damianjarczok/Solar-tracker/Schemat.png

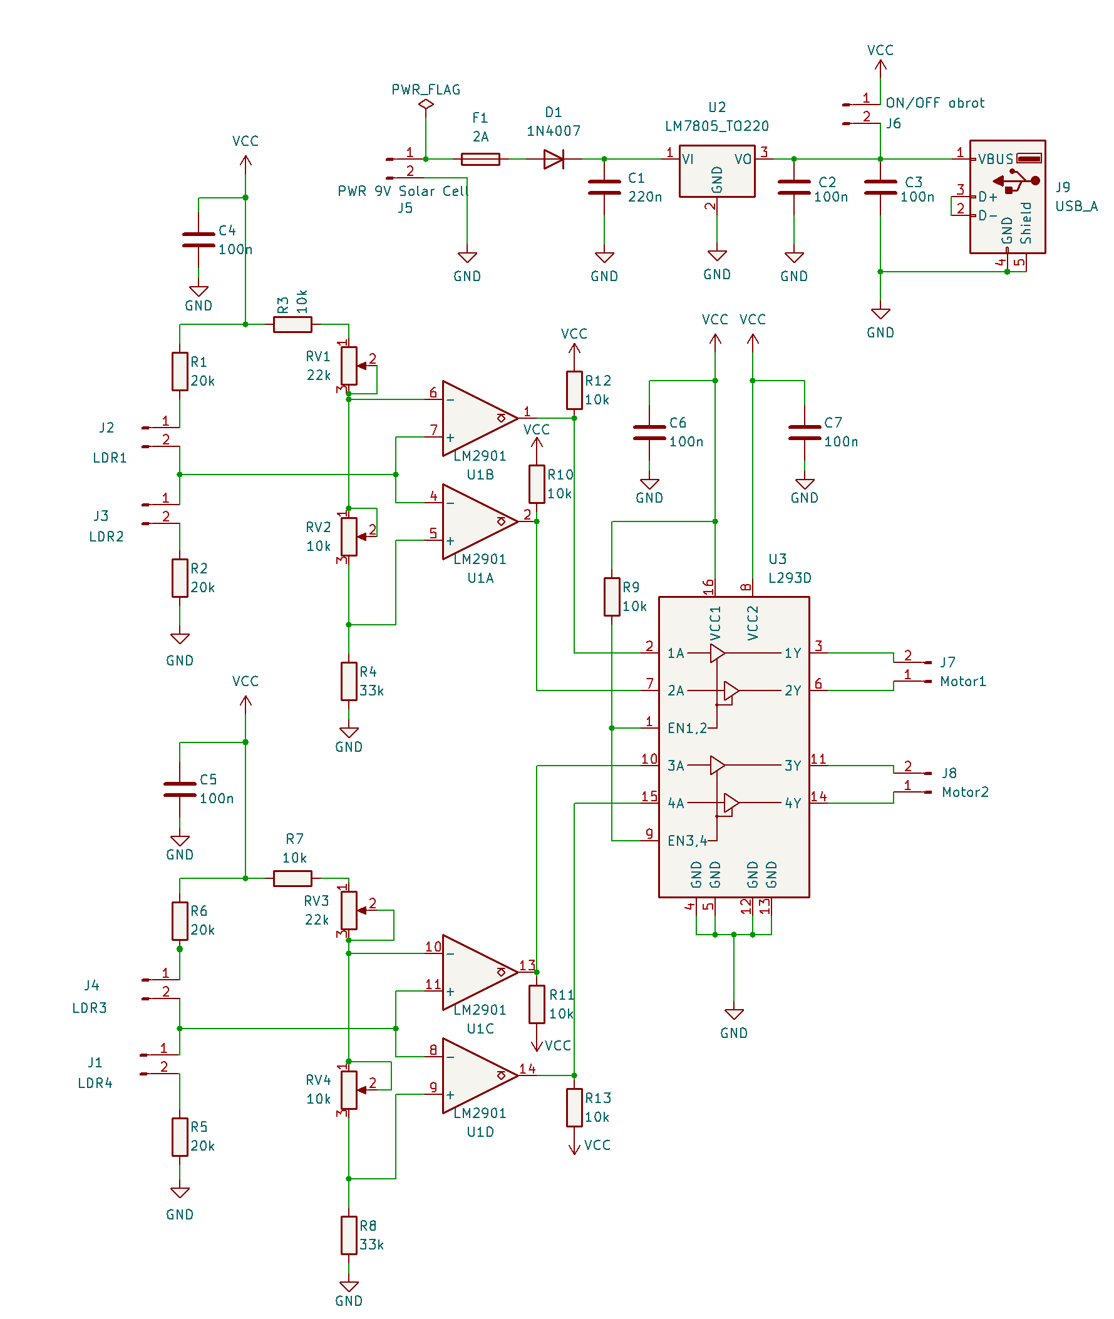
Schemat.png
