damianjarczok/Solar-tracker/SolarTracker.kicad_pcb

## KiCad design SolarTracker.kicad_pcb (2025-08-06)

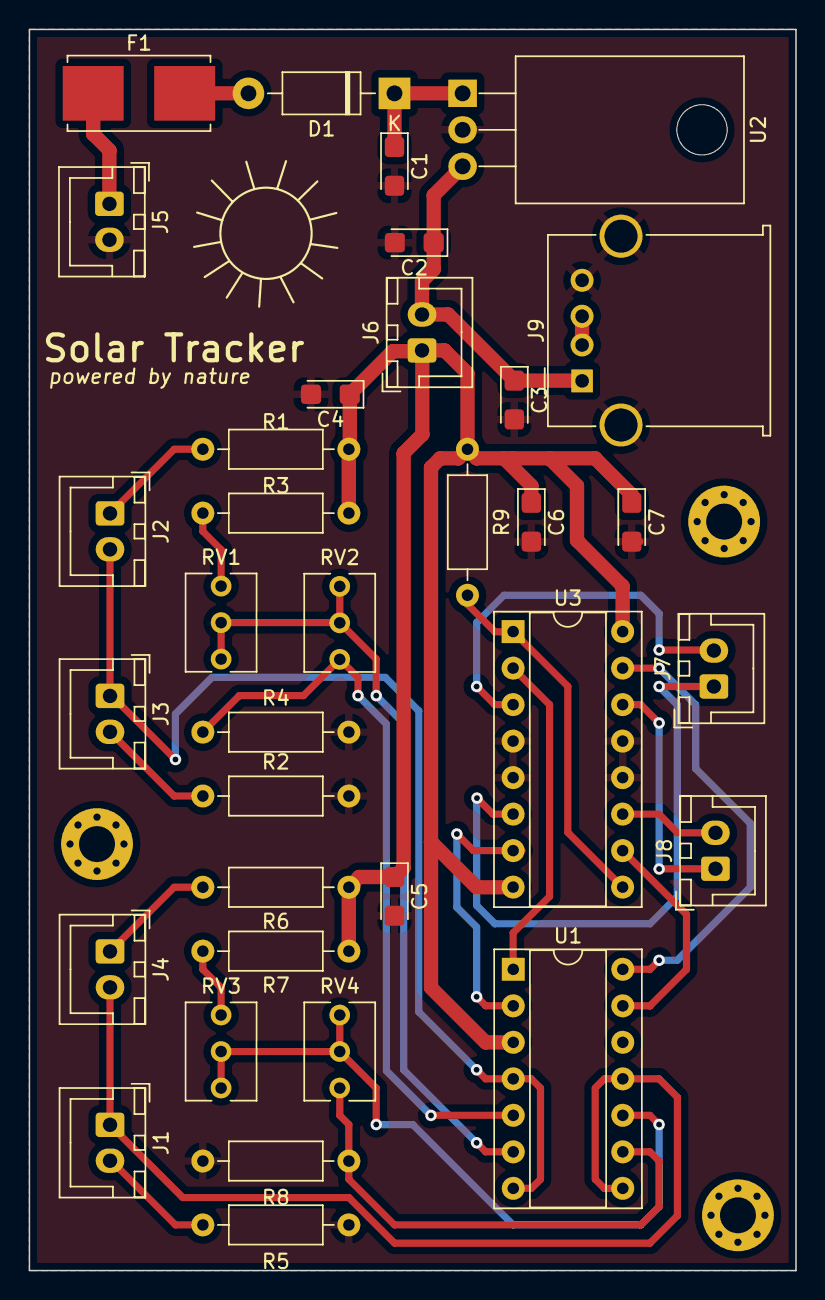
[picture p6: board SolarTracker.kicad_pcb from above]

Board: 2 copper layers, 53.3 x 86.4 mm, 34 parts (0 on the bottom side), 28 nets.

Parts:
C1: 220n; CP_EIA-3216-18_Kemet-A
C2, C3, C4, C5, C6, C7: 100n; CP_EIA-3216-18_Kemet-A
D1: 1N4007; D_DO-41_SOD81_P10.16mm_Horizontal
F1: 2A; Fuseholder_Littelfuse_Nano2_154x
J1: LDR4; JST_XH_B2B-XH-A_1x02_P2.50mm_Vertical
J2: LDR1; JST_XH_B2B-XH-A_1x02_P2.50mm_Vertical
J3: LDR2; JST_XH_B2B-XH-A_1x02_P2.50mm_Vertical
J4: LDR3; JST_XH_B2B-XH-A_1x02_P2.50mm_Vertical
J5: PWR 9V - 30V Solar Cell; JST_XH_B2B-XH-A_1x02_P2.50mm_Vertical
J6: ON/OFF obrot; JST_XH_B2B-XH-A_1x02_P2.50mm_Vertical
J7: Motor1; JST_XH_B2B-XH-A_1x02_P2.50mm_Vertical
J8: Motor2; JST_XH_B2B-XH-A_1x02_P2.50mm_Vertical
J9: USB_A; USB_A_Molex_67643_Horizontal
R1, R2, R5, R6: 20k; R_Axial_DIN0207_L6.3mm_D2.5mm_P10.16mm_Horizontal
R3, R7, R9: 10k; R_Axial_DIN0207_L6.3mm_D2.5mm_P10.16mm_Horizontal
R4, R8: 33k; R_Axial_DIN0207_L6.3mm_D2.5mm_P10.16mm_Horizontal
RV1, RV3: 22k; Potentiometer_Vishay_T73XW_Horizontal
RV2, RV4: 10k; Potentiometer_Vishay_T73XW_Horizontal
U1: LM2901; DIP-14_W7.62mm_Socket
U2: LM7805_TO220; TO-220-3_Horizontal_TabDown
U3: L293D; DIP-16_W7.62mm_Socket

Connections:
GND: C1.2, C2.2, C3.2, C4.2, C5.2, C6.2, C7.2, J5.2, J9.4 (GND), J9.5 (Shield), R2.2, R4.2, R5.2, R8.2, U2.2 (GND), U3.4 (GND), U3.5 (GND), U3.12 (GND), U3.13 (GND)
unnamed: C1.1, D1.1 (K), U2.1 (VI)
unnamed: D1.2 (A), F1.2
unnamed: F1.1, J5.1
unnamed: J1.1, J4.2, U1.8 (-), U1.11 (+)
unnamed: J1.2, R5.1
unnamed: J2.1, R1.2
unnamed: J2.2, J3.1, U1.4 (-), U1.7 (+)
unnamed: J3.2, R2.1
unnamed: J4.1, R6.2
unnamed: J7.1, U3.6 (2Y)
unnamed: J7.2, U3.3 (1Y)
unnamed: J8.1, U3.14 (4Y)
unnamed: J8.2, U3.11 (3Y)
unnamed: J9.2 (D-), J9.3 (D+)
unnamed: R3.2, RV1.1
unnamed: R4.1, RV2.3, U1.5 (+)
unnamed: R7.2, RV3.1
unnamed: R8.1, RV4.3, U1.9 (+)
unnamed: R9.2, U3.1 (EN1,2), U3.9 (EN3,4)
unnamed: RV1.2, RV1.3, RV2.1, RV2.2, U1.6 (-)
unnamed: RV3.2, RV3.3, RV4.1, RV4.2, U1.10 (-)
unnamed: U1.1, U3.2 (1A)
unnamed: U1.2, U3.7 (2A)
unnamed: U1.13, U3.10 (3A)
unnamed: U1.14, U3.15 (4A)
unnamed: C2.1, C3.1, J6.2, J9.1 (VBUS), U2.3 (VO)
VCC: C4.1, C5.1, C6.1, C7.1, J6.1, R1.1, R3.1, R6.1, R7.1, R9.1, U3.8 (VCC2), U3.16 (VCC1)
